fallenb0x/podajnik-lekow/modele stl/kąt lewo.stl

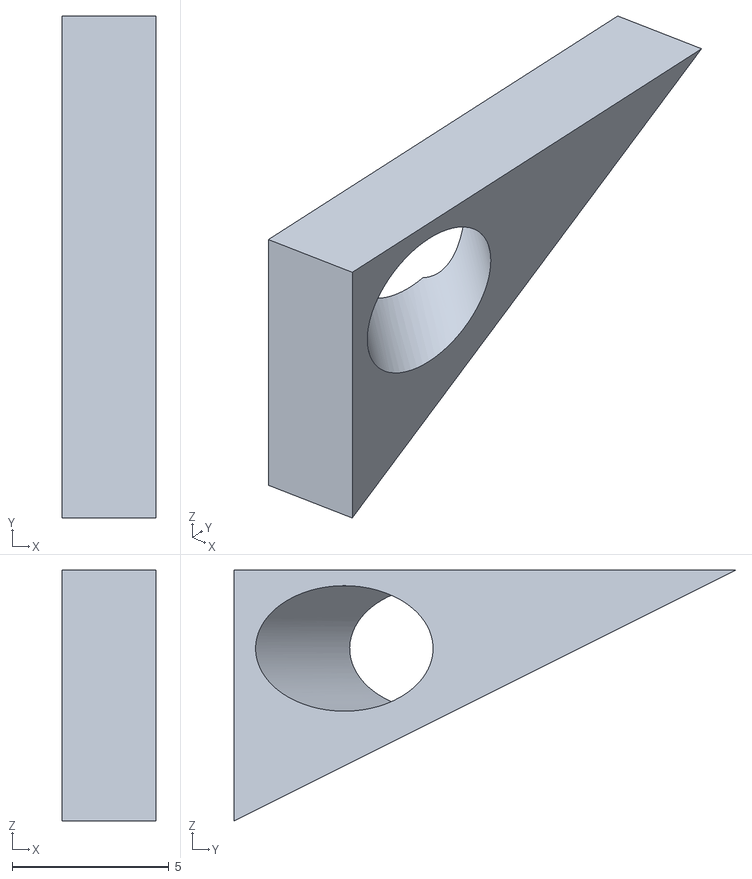
[picture p1: CAD file, 2026-11-06]
modele stl/kąt lewo.stl
3.00 x 16.0 x 8.00
