fallenb0x/podajnik-lekow/modele stl/dach tył.stl

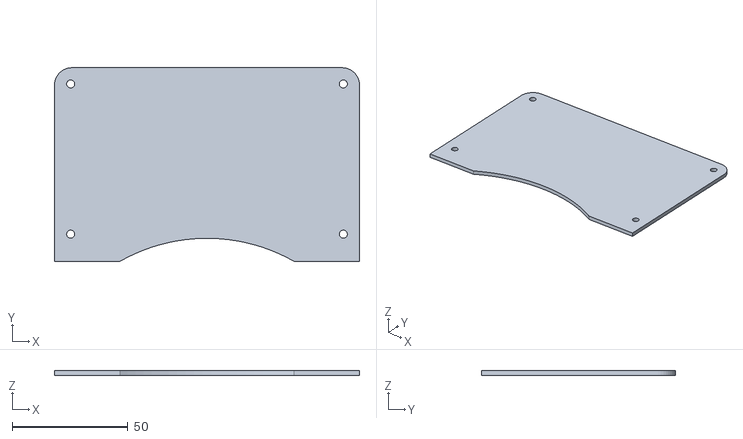
[picture p2: CAD file, 2026-11-06]
modele stl/dach tył.stl
132.0 x 83.8 x 2.00
