fallenb0x/podajnik-lekow/modele stl/dystans na silnik.stl

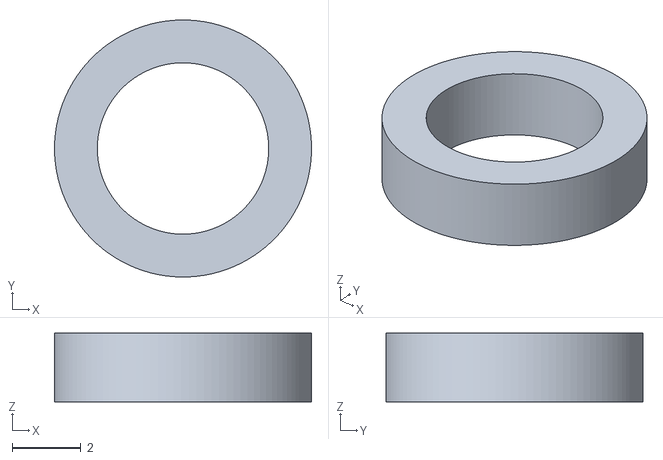
[picture p3: CAD file, 2026-11-06]
modele stl/dystans na silnik.stl
7.50 x 7.50 x 2.00
