fallenb0x/podajnik-lekow/modele stl/baza na sensor.stl

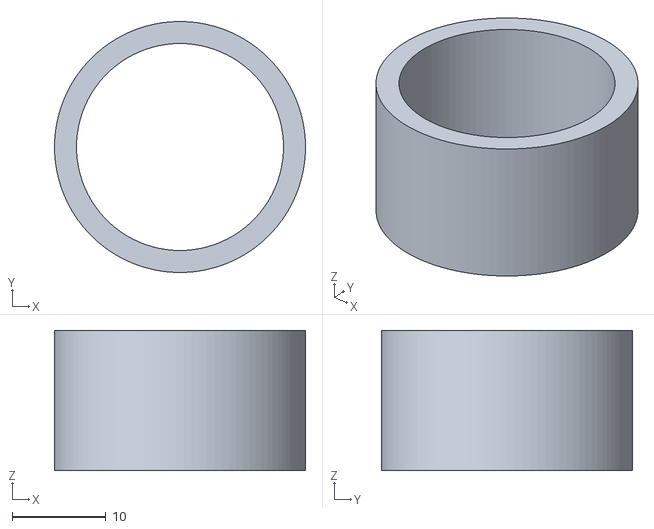
[picture p4: CAD file, 2026-11-06]
modele stl/baza na sensor.stl
26.8 x 26.8 x 15.0
