fallenb0x/podajnik-lekow/modele stl/maska.stl

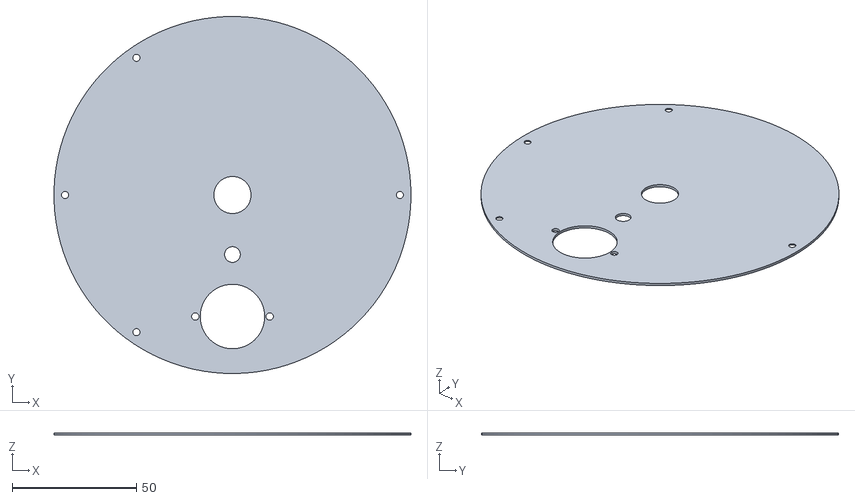
[picture p5: CAD file, 2026-11-06]
modele stl/maska.stl
143.9 x 144.0 x 1.00
