fallenb0x/podajnik-lekow/modele stl/baza.stl

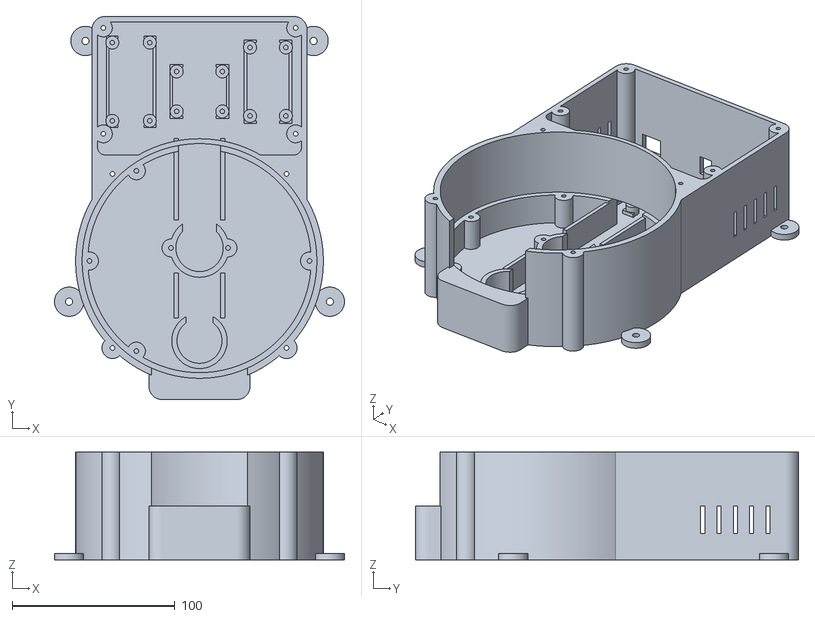
[picture p6: CAD file, 2026-11-03]
modele stl/baza.stl
178.0 x 235.0 x 66.0
