fallenb0x/podajnik-lekow/modele stl/dach przód.stl

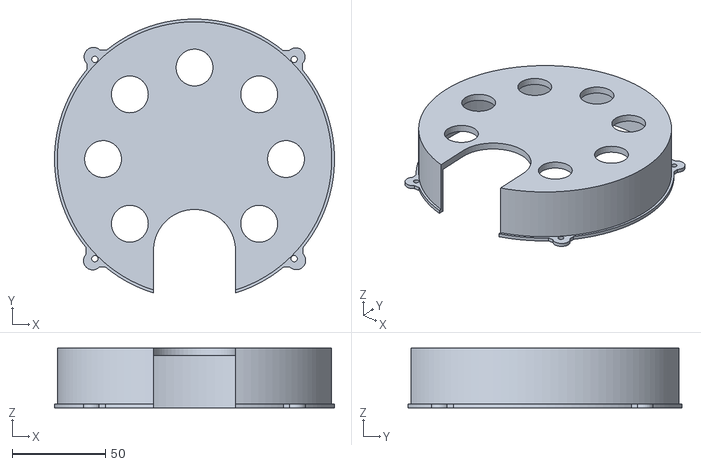
[picture p7: CAD file, 2026-11-03]
modele stl/dach przód.stl
150.0 x 146.7 x 32.0
