fallenb0x/podajnik-lekow/modele stl/Bęben rewolwerowy.stl

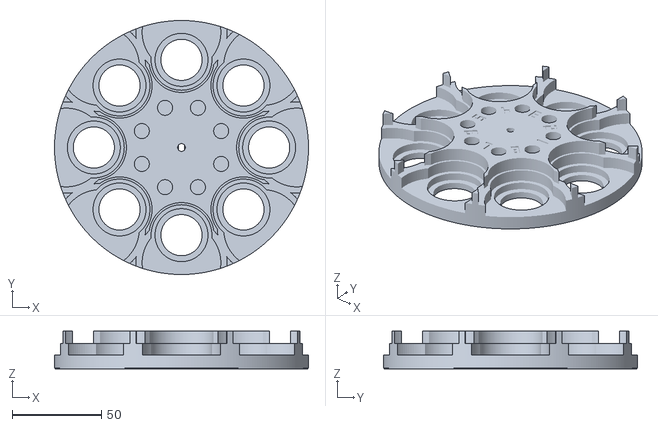
[picture p8: CAD file, 2026-11-03]
modele stl/Bęben rewolwerowy.stl
142.0 x 142.0 x 21.0
