fallenb0x/podajnik-lekow/(list of files, cad)

Other CAD files:
modele stl/kąt prawo.stl
