fallenb0x/podajnik-lekow/program/program.ino

#include <Arduino.h>
#include <EEPROM.h>
#include <WiFi.h>
#include <WebServer.h>
#include <RtcDS1302.h>
#include <ThreeWire.h>

/* =========================================================================
   DEFINICJA PINÓW ZGODNIE Z OPISEM
   ========================================================================= */
#define PIN_LED_GREEN    1   // Zielona dioda (obecność kubeczka)
#define PIN_LED_RED      2   // Czerwona dioda (brak kubeczka / błąd / stan czuwania)
#define PIN_RTC_CLK      5   // DS1302 SCLK / CLK
#define PIN_RTC_DAT      6   // DS1302 IO / DAT
#define PIN_RTC_RST      7   // DS1302 CE / RST
#define PIN_BUZZER       8   // Głośniczek / buzzer (GPIO8 / P8)
#define PIN_STEP_IN1     10  // ULN2003 Driver IN1
#define PIN_STEP_IN2     11  // ULN2003 Driver IN2
#define PIN_STEP_IN3     12  // ULN2003 Driver IN3
#define PIN_STEP_IN4     13  // ULN2003 Driver IN4
#define PIN_US_TRIG      15  // AJ-SR04M TRIG (P15)
#define PIN_US_ECHO      16  // AJ-SR04M ECHO (P16)
#define PIN_BUTTON       19  // Przycisk ręcznego dozowania (do GND z PULLUP)

/* =========================================================================
   DANE PUNKTU DOSTĘPOWEGO (AP) I SERWERA WWW
   ========================================================================= */
const char* AP_SSID = "Podajnik Leków";
const char* AP_PASS = "leki1234";

WebServer server(80);

/* =========================================================================
   STRUKTURA USTAWIEŃ W PAMIĘCI EEPROM (CZUJNIK AJ-SR04M)
   ========================================================================= */
#define EEPROM_MAGIC 0x4D454437 // Wersja 7 konfiguracji (AJ-SR04M)

struct Config {
  uint32_t magic;
  int cupMinDistCm;        // Minimalna odległość kubeczka w cm (np. 3 cm)
  int cupMaxDistCm;        // Maksymalna odległość kubeczka w cm (np. 15 cm)
  int slotSteps[8];        // Ilość kroków silnika dla każdego z 8 slotów
  int currentSlot;         // Wybrany aktywny slot (0 - 7)
  int stepDelayMicros;     // Prędkość silnika w us
  bool buzzerMuted;        // Wyciszenie głośniczka
  int scheduleHours[8];    // Harmonogram: godziny (0 - 23) lub -1
  int scheduleMinutes[8];  // Harmonogram: minuty (0 - 59)
  int scheduleSlot[8];     // Który slot (0 - 7) ma zostać podany o danej godzinie
  int scheduleCount;       // Liczba wpisów w harmonogramie
};

Config config;

/* Inicjalizacja zegara czasu rzeczywistego DS1302 */
ThreeWire myWire(PIN_RTC_DAT, PIN_RTC_CLK, PIN_RTC_RST);
RtcDS1302<ThreeWire> Rtc(myWire);

/* Półkrokowa sekwencja sterowania 28BYJ-48 (8 kroków) */
const uint8_t stepSequence[8][4] = {
  {1, 0, 0, 0},
  {1, 1, 0, 0},
  {0, 1, 0, 0},
  {0, 1, 1, 0},
  {0, 0, 1, 0},
  {0, 0, 1, 1},
  {0, 0, 0, 1},
  {1, 0, 0, 1}
};

int currentStepIndex = 0;
int lastDispenseMinute = -1;
unsigned long lastSensorCheck = 0;
bool lastCupPresent = false;
float cachedDistanceCm = 0.0;
String lastStatusMessage = "Urządzenie gotowe do pracy.";

// Zmienne przypomnienia po 5 minutach
bool waitingForCupPickup = false;
unsigned long dispenseTimestamp = 0;
unsigned long lastReminderAlarm = 0;
const unsigned long CUP_TIMEOUT_MS = 300000; // 5 minut

/* =========================================================================
   FUNKCJE SILNIKA KROKOWEGO
   ========================================================================= */
void motorPowerOff() {
  digitalWrite(PIN_STEP_IN1, LOW);
  digitalWrite(PIN_STEP_IN2, LOW);
  digitalWrite(PIN_STEP_IN3, LOW);
  digitalWrite(PIN_STEP_IN4, LOW);
}

void stepMotorSingle(int dir) {
  if (dir > 0) {
    currentStepIndex = (currentStepIndex + 1) % 8;
  } else {
    currentStepIndex = (currentStepIndex + 7) % 8;
  }
  digitalWrite(PIN_STEP_IN1, stepSequence[currentStepIndex][0]);
  digitalWrite(PIN_STEP_IN2, stepSequence[currentStepIndex][1]);
  digitalWrite(PIN_STEP_IN3, stepSequence[currentStepIndex][2]);
  digitalWrite(PIN_STEP_IN4, stepSequence[currentStepIndex][3]);
}

void rotateMotor(int steps, int dir = 1) {
  for (int i = 0; i < steps; i++) {
    stepMotorSingle(dir);
    delayMicroseconds(config.stepDelayMicros > 800 ? config.stepDelayMicros : 1200);
    yield();
  }
  motorPowerOff();
}

/* =========================================================================
   FUNKCJE SYGNALIZACJI DŹWIĘKOWEJ
   ========================================================================= */
void beep(int frequency = 2000, int durationMs = 100) {
  if (config.buzzerMuted) return;
  tone(PIN_BUZZER, frequency, durationMs);
}

void playDispenseMelody() {
  if (config.buzzerMuted) return;
  const int notes[] = { 1047, 1319, 1568, 2093 };
  const int durations[] = { 100, 100, 100, 250 };
  for (int i = 0; i < 4; i++) {
    tone(PIN_BUZZER, notes[i], durations[i]);
    delay(durations[i] + 30);
  }
}

/* =========================================================================
   POMIAR ODLEGŁOŚCI - CZUJNIK ULTRADŹWIĘKOWY AJ-SR04M (OPTYMALIZACJA 3.3V)
   ========================================================================= */
float measureDistanceCm() {
  // 1. Zapewnienie czystego stanu niskiego przed strzałem
  digitalWrite(PIN_US_TRIG, LOW);
  delayMicroseconds(10);

  // 2. Wysłanie dłuższego impulsu wyzwalającego (30 us) - kluczowe dla zasilania 3.3V!
  digitalWrite(PIN_US_TRIG, HIGH);
  delayMicroseconds(30);
  digitalWrite(PIN_US_TRIG, LOW);

  // 3. Oczekiwanie na odpowiedź ECHO (timeout 60 000 us = 60 ms)
  unsigned long duration = pulseIn(PIN_US_ECHO, HIGH, 60000);
  if (duration == 0) {
    return -1.0; // Brak echa / brak odbicia
  }

  // 4. Przeliczenie na cm: dźwięk pokonuje drogę tam i z powrotem (343 m/s)
  float dist = (float)duration * 0.01715f;
  return dist;
}

// Uśrednianie kilku próbek z odrzuceniem błędów
float getStableDistanceCm() {
  float sum = 0;
  int validCount = 0;
  
  for (int i = 0; i < 4; i++) {
    float d = measureDistanceCm();
    if (d >= 1.0 && d <= 10000.0) {
      sum += d;
      validCount++;
    }
    delay(35); // Dłuższy odstęp między impulsami dla naładowania przetwornika przy 3.3V
  }

  if (validCount > 0) {
    cachedDistanceCm = sum / validCount;
  } else {
    // Sprawdzenie pojedynczego odczytu
    float single = measureDistanceCm();
    cachedDistanceCm = (single >= 1.0 && single <= 10000.0) ? single : -1.0;
  }
  return cachedDistanceCm;
}

bool checkCupPresent() {
  if (cachedDistanceCm <= 0) return false;
  // Kubek znajduje się w zdefiniowanym przedziale odległości (np. 3 - 15 cm)
  return (cachedDistanceCm >= config.cupMinDistCm && cachedDistanceCm <= config.cupMaxDistCm);
}

void updateSensorAndIndicators() {
  getStableDistanceCm();
  bool cup = checkCupPresent();
  lastCupPresent = cup;

  if (cup) {
    digitalWrite(PIN_LED_GREEN, HIGH);
    digitalWrite(PIN_LED_RED, LOW);
  } else {
    digitalWrite(PIN_LED_GREEN, LOW);
    digitalWrite(PIN_LED_RED, HIGH);

    if (waitingForCupPickup) {
      waitingForCupPickup = false;
      noTone(PIN_BUZZER);
      lastStatusMessage = "Kubeczek z lekiem został odebrany. Alarm wyłączony.";
      Serial.println("[ALARM] Kubek odebrany! Zatrzymano alarm.");
    }
  }

  Serial.printf("[AJ-SR04M] Odleglosc: %.1f cm (Zakres: %d-%d cm) => Kubek: %s\n", 
                cachedDistanceCm, config.cupMinDistCm, config.cupMaxDistCm, 
                cup ? "OBECNY (ZIELONY)" : "BRAK (CZERWONY)");
}

/* =========================================================================
   LOGIKA PODAWANIA LEKÓW
   ========================================================================= */
bool dispenseMedication(int slotIdx, const char* reason) {
  if (slotIdx < 0 || slotIdx >= 8) slotIdx = config.currentSlot;
  int stepsToRun = config.slotSteps[slotIdx];

  Serial.printf("\n[DOZOWNIK] Podawanie slotu #%d (%d krokow). Powod: %s\n", slotIdx + 1, stepsToRun, reason);

  rotateMotor(stepsToRun, 1);
  playDispenseMelody();

  config.currentSlot = (slotIdx + 1) % 8;
  EEPROM.put(0, config);
  EEPROM.commit();

  waitingForCupPickup = true;
  dispenseTimestamp = millis();

  lastStatusMessage = String("Podano slot #") + (slotIdx + 1) + " (" + stepsToRun + " kroków). Następny slot: #" + (config.currentSlot + 1);
  Serial.printf("[DOZOWNIK] Podano pomyslnie. Następny slot: #%d\n\n", config.currentSlot + 1);
  return true;
}

/* =========================================================================
   ZARZĄDZANIE PAMIĘCIĄ EEPROM
   ========================================================================= */
void loadConfig() {
  EEPROM.begin(sizeof(Config));
  EEPROM.get(0, config);
  if (config.magic != EEPROM_MAGIC) {
    Serial.println("[EEPROM] Inicjalizacja domyslnych wartosci v7 (AJ-SR04M)...");
    config.magic = EEPROM_MAGIC;
    config.cupMinDistCm = 2;   // Minimalna odległość (np. 2 cm)
    config.cupMaxDistCm = 15;  // Maksymalna odległość kubeczka (np. 15 cm)
    config.currentSlot = 0;
    config.stepDelayMicros = 1200;
    config.buzzerMuted = false;

    for (int i = 0; i < 8; i++) {
      config.slotSteps[i] = 512;
    }

    config.scheduleCount = 1;
    config.scheduleHours[0] = 8;
    config.scheduleMinutes[0] = 0;
    config.scheduleSlot[0] = 0;
    for (int i = 1; i < 8; i++) {
      config.scheduleHours[i] = -1;
      config.scheduleMinutes[i] = 0;
      config.scheduleSlot[i] = i;
    }
    EEPROM.put(0, config);
    EEPROM.commit();
  }
}

void saveConfig() {
  EEPROM.put(0, config);
  EEPROM.commit();
}

/* =========================================================================
   INTERFEJS WEBUI - DARK THEME (HTML/CSS/JS)
   ========================================================================= */
const char PAGE_MAIN[] PROGMEM = R"rawliteral(
<!DOCTYPE html>
<html lang="pl">
<head>
  <meta charset="UTF-8">
  <meta name="viewport" content="width=device-width, initial-scale=1.0">
  <title>Podajnik Leków - Panel</title>
  <style>
    :root {
      --bg: #121418;
      --card: #1c1f26;
      --card-border: #2a303c;
      --text: #e2e8f0;
      --text-muted: #94a3b8;
      --primary: #3b82f6;
      --primary-hover: #2563eb;
      --green: #10b981;
      --red: #ef4444;
      --slot-bg: #262c38;
      --slot-active: #1e3a8a;
    }
    * { box-sizing: border-box; }
    body {
      font-family: -apple-system, BlinkMacSystemFont, 'Segoe UI', Roboto, Helvetica, Arial, sans-serif;
      background: var(--bg);
      color: var(--text);
      margin: 0;
      padding: 16px;
    }
    .container { max-width: 650px; margin: 0 auto; }
    h1 {
      text-align: center;
      color: #60a5fa;
      margin: 10px 0 4px 0;
      font-size: 26px;
      letter-spacing: 0.5px;
    }
    p.subtitle {
      text-align: center;
      color: var(--text-muted);
      margin-top: 0;
      margin-bottom: 22px;
      font-size: 14px;
    }
    .card {
      background: var(--card);
      border: 1px solid var(--card-border);
      border-radius: 14px;
      padding: 18px;
      margin-bottom: 18px;
      box-shadow: 0 8px 24px rgba(0,0,0,0.35);
    }
    h2 {
      font-size: 17px;
      margin: 0 0 14px 0;
      border-bottom: 1px solid var(--card-border);
      padding-bottom: 10px;
      color: #93c5fd;
      display: flex;
      align-items: center;
      gap: 8px;
    }
    .status-badge {
      display: inline-block;
      padding: 6px 16px;
      border-radius: 20px;
      font-weight: 700;
      font-size: 13px;
      letter-spacing: 0.5px;
      color: white;
    }
    .badge-cup-yes { background-color: var(--green); box-shadow: 0 0 12px rgba(16,185,129,0.4); }
    .badge-cup-no { background-color: var(--red); box-shadow: 0 0 12px rgba(239,68,68,0.4); }
    .btn {
      display: block;
      width: 100%;
      background: var(--primary);
      color: white;
      border: none;
      padding: 12px;
      border-radius: 8px;
      font-size: 15px;
      font-weight: 600;
      cursor: pointer;
      text-align: center;
      transition: background 0.2s, transform 0.1s;
    }
    .btn:hover { background: var(--primary-hover); }
    .btn:active { transform: scale(0.99); }
    .btn-secondary { background: #374151; }
    .btn-secondary:hover { background: #4b5563; }
    .row {
      display: flex;
      justify-content: space-between;
      align-items: center;
      margin-bottom: 12px;
      font-size: 14px;
    }
    label { font-weight: 500; color: var(--text-muted); }
    input[type="number"], input[type="text"], input[type="time"] {
      background: #111827;
      border: 1px solid #374151;
      color: #f3f4f6;
      padding: 8px 10px;
      border-radius: 8px;
      font-size: 14px;
      text-align: center;
      outline: none;
    }
    .dist-highlight {
      font-size: 20px;
      font-weight: bold;
      color: #38bdf8;
    }
    .slots-grid {
      display: grid;
      grid-template-columns: repeat(2, 1fr);
      gap: 10px;
      margin-bottom: 14px;
    }
    .slot-card {
      background: var(--slot-bg);
      border: 1px solid #334155;
      padding: 10px 12px;
      border-radius: 8px;
      display: flex;
      justify-content: space-between;
      align-items: center;
    }
    .slot-card.active-slot {
      border-color: #60a5fa;
      background: var(--slot-active);
    }
    .slot-label { font-size: 13px; font-weight: 600; color: #93c5fd; }
    .slot-steps-in { width: 85px !important; }
    .log-box {
      background: #111827;
      border: 1px solid #1f2937;
      padding: 10px;
      border-radius: 8px;
      font-family: monospace;
      font-size: 13px;
      color: #94a3b8;
    }
  </style>
</head>
<body>
  <div class="container">
    <h1>💊 Podajnik Leków</h1>
    <p class="subtitle">Panel WebUI Dark Mode • IP: 192.168.4.1</p>

    <!-- KARTA 1: STATUS -->
    <div class="card">
      <h2>📊 Bieżący stan</h2>
      <div class="row">
        <span>Status kubeczka:</span>
        <span id="cupBadge" class="status-badge badge-cup-no">Łączenie...</span>
      </div>

      <div class="row" style="margin-bottom: 6px;">
        <span>Odległość (AJ-SR04M):</span>
        <span id="valDist" class="dist-highlight">-- cm</span>
      </div>
      <div class="row">
        <span>Zdefiniowany zakres kubka:</span>
        <strong id="valRange" style="color: #94a3b8;">-- cm</strong>
      </div>
      <div class="row">
        <span>Zegar DS1302:</span>
        <strong id="valTime" style="color: #60a5fa;">--:--:--</strong>
      </div>
      <div class="row">
        <span>Kolejny slot do podania:</span>
        <strong id="valNextSlot" style="color: #34d399;">Slot #1</strong>
      </div>
      <div class="row">
        <span>Głośniczek dźwiękowy:</span>
        <button id="btnMuteToggle" class="status-badge" style="border:none; cursor:pointer;" onclick="toggleMute()">Ładowanie...</button>
      </div>
      <div class="row" style="margin-bottom: 4px;">
        <span>Komunikat:</span>
      </div>
      <div id="valStatus" class="log-box">Wczytywanie danych...</div>

      <button class="btn" style="margin-top: 14px;" onclick="dispenseCurrent()">PODAJ AKTUALNY SLOT</button>
      <button class="btn btn-secondary" style="margin-top: 8px;" onclick="manualNextSlot()">OBRÓĆ DO NASTĘPNEGO SLOTU</button>
    </div>

    <!-- KARTA 2: KALIBRACJA CZUJNIKA AJ-SR04M -->
    <div class="card">
      <h2>📏 Kalibracja czujnika odległości (AJ-SR04M)</h2>
      <p style="font-size: 13px; color: var(--text-muted); margin-top: 0;">Określ przedział odległości, w którym sensor widzi obecność kubka:</p>
      <form action="/save_sensor" method="POST">
        <div class="row">
          <label>Minimalna odległość (cm):</label>
          <input type="number" name="min_dist" id="inMinDist" min="0" max="10000" required>
        </div>
        <div class="row">
          <label>Maksymalna odległość (cm):</label>
          <input type="number" name="max_dist" id="inMaxDist" min="1" max="10000" required>
        </div>
        <button type="submit" class="btn btn-secondary" style="margin-top: 8px;">Zapisz zakres odległości</button>
      </form>
    </div>

    <!-- KARTA 3: KALIBRACJA 8 SLOTÓW (PRZEDZIAŁEK) -->
    <div class="card">
      <h2>⚙️ Kalibracja kroków silnika dla 8 slotów</h2>
      <p style="font-size: 13px; color: var(--text-muted); margin-top: 0;">Ustaw indywidualną liczbę kroków silnika dla każdej przedziałki:</p>
      <form action="/save_slots" method="POST">
        <div class="slots-grid">
          <div class="slot-card" id="sc0"><span class="slot-label">Slot #1</span><input type="number" name="s0" id="s0" class="slot-steps-in" min="1" max="16384"></div>
          <div class="slot-card" id="sc1"><span class="slot-label">Slot #2</span><input type="number" name="s1" id="s1" class="slot-steps-in" min="1" max="16384"></div>
          <div class="slot-card" id="sc2"><span class="slot-label">Slot #3</span><input type="number" name="s2" id="s2" class="slot-steps-in" min="1" max="16384"></div>
          <div class="slot-card" id="sc3"><span class="slot-label">Slot #4</span><input type="number" name="s3" id="s3" class="slot-steps-in" min="1" max="16384"></div>
          <div class="slot-card" id="sc4"><span class="slot-label">Slot #5</span><input type="number" name="s4" id="s4" class="slot-steps-in" min="1" max="16384"></div>
          <div class="slot-card" id="sc5"><span class="slot-label">Slot #6</span><input type="number" name="s5" id="s5" class="slot-steps-in" min="1" max="16384"></div>
          <div class="slot-card" id="sc6"><span class="slot-label">Slot #7</span><input type="number" name="s6" id="s6" class="slot-steps-in" min="1" max="16384"></div>
          <div class="slot-card" id="sc7"><span class="slot-label">Slot #8</span><input type="number" name="s7" id="s7" class="slot-steps-in" min="1" max="16384"></div>
        </div>
        <div class="row">
          <label>Wyciszenie głośniczka:</label>
          <input type="checkbox" name="muted" id="inMuted" style="transform: scale(1.3); accent-color: var(--primary);">
        </div>
        <button type="submit" class="btn btn-secondary">Zapisz ustawienia slotów</button>
      </form>

      <div style="display: flex; gap: 8px; margin-top: 10px;">
        <button type="button" class="btn btn-secondary" style="font-size: 13px;" onclick="testRotate(64)">+64</button>
        <button type="button" class="btn btn-secondary" style="font-size: 13px;" onclick="testRotate(-64)">-64</button>
        <button type="button" class="btn btn-secondary" style="font-size: 13px;" onclick="testRotate(256)">+256</button>
        <button type="button" class="btn btn-secondary" style="font-size: 13px;" onclick="testRotate(-256)">-256</button>
      </div>

      <div style="margin-top: 15px; padding-top: 12px; border-top: 1px solid var(--card-border);">
        <label style="color: #93c5fd; font-weight: 600;">📍 Punkt zerowy podajnika:</label>
        <p style="font-size: 12px; color: var(--text-muted); margin: 4px 0 10px 0;">Użyj przycisków powyżej aby ustawić komorę na pozycji wyjściowej, a następnie zapisz to jako Punkt Zero (Slot #1):</p>
        <div style="display: flex; gap: 10px;">
          <button type="button" class="btn" style="background: #059669;" onclick="setZeroPoint()">USTAW AKTUALNĄ POZYCJĘ JAKO PUNKT ZERO (SLOT #1)</button>
        </div>
      </div>
    </div>

    <!-- KARTA 4: HARMONOGRAM -->
    <div class="card">
      <h2>⏰ Codzienny harmonogram podawania</h2>
      <p style="font-size: 13px; color: var(--text-muted); margin-top: 0;">Podajnik obróci się automatycznie każdego dnia dokładnie o wybranej godzinie:</p>
      <form action="/save_schedule" method="POST">
        <div class="row" style="justify-content: flex-start; gap: 15px;">
          <label style="font-size: 15px; color: #fff;">Godzina podania:</label>
          <input type="time" name="daily_time" id="dailyTime" style="font-size: 16px; padding: 10px; width: 140px;" required>
        </div>
        <button type="submit" class="btn btn-secondary" style="margin-top: 10px;">Zapisz codzienną godzinę</button>
      </form>
    </div>

    <!-- KARTA 5: ZEGAR -->
    <div class="card">
      <h2>🕒 Synchronizacja czasu</h2>
      <button class="btn btn-secondary" onclick="syncBrowserTime()">Pobierz czas z telefonu / komputera</button>
    </div>
  </div>

  <script>
    let firstLoad = true;

    function refreshData() {
      fetch('/api/data')
        .then(r => r.json())
        .then(d => {
          document.getElementById('cupBadge').className = 'status-badge ' + (d.cup ? 'badge-cup-yes' : 'badge-cup-no');
          document.getElementById('cupBadge').innerText = d.cup ? 'KUBEK NA MIEJSCU' : 'BRAK KUBECZKA';
          
          document.getElementById('valDist').innerText = (d.dist >= 0) ? d.dist + ' cm' : 'Brak echa / poza zakresem';
          document.getElementById('valRange').innerText = d.minDist + ' - ' + d.maxDist + ' cm';

          document.getElementById('valTime').innerText = d.time;
          document.getElementById('valNextSlot').innerText = 'Slot #' + (d.curSlot + 1);
          document.getElementById('valStatus').innerText = d.statusMsg;

          // Automatyczne dopasowanie czasu przy otwarciu strony
          checkAutoSyncRtc(d.time);

          // Przycisk szybkiego wyciszenia
          let muteBtn = document.getElementById('btnMuteToggle');
          if (d.muted) {
            muteBtn.innerText = '🔇 WYCISZONY (Kliknij, aby włączyć)';
            muteBtn.style.backgroundColor = '#ef4444';
          } else {
            muteBtn.innerText = '🔊 DŹWIĘK WŁĄCZONY (Kliknij, aby wyciszyć)';
            muteBtn.style.backgroundColor = '#10b981';
          }

          // Podświetlenie aktywnego slotu
          for (let i = 0; i < 8; i++) {
            let el = document.getElementById('sc' + i);
            if (el) {
              if (i === d.curSlot) el.classList.add('active-slot');
              else el.classList.remove('active-slot');
            }
          }

          if (firstLoad) {
            document.getElementById('inMinDist').value = d.minDist;
            document.getElementById('inMaxDist').value = d.maxDist;
            document.getElementById('inMuted').checked = d.muted;

            for (let i = 0; i < 8; i++) {
              document.getElementById('s' + i).value = d.slotSteps[i];
            }
            if (d.dailyTime) {
              document.getElementById('dailyTime').value = d.dailyTime;
            }
            firstLoad = false;
          }
        });
    }

    function dispenseCurrent() {
      fetch('/api/dispense', { method: 'POST' })
        .then(r => r.text())
        .then(msg => {
          alert(msg);
          refreshData();
        });
    }

    function manualNextSlot() {
      fetch('/api/force_advance', { method: 'POST' })
        .then(r => r.text())
        .then(msg => {
          alert(msg);
          refreshData();
        });
    }

    function toggleMute() {
      fetch('/api/toggle_mute', { method: 'POST' })
        .then(() => refreshData());
    }

    function testRotate(st) {
      fetch('/api/rotate?steps=' + st, { method: 'POST' })
        .then(() => refreshData());
    }

    function setZeroPoint() {
      if (confirm('Czy chcesz ustawić bieżącą pozycję silnika jako Punkt Zero (Slot #1)?')) {
        fetch('/api/set_zero', { method: 'POST' })
          .then(r => r.text())
          .then(msg => {
            alert(msg);
            refreshData();
          });
      }
    }

    function syncBrowserTime() {
      const now = new Date();
      fetch('/api/set_time?h=' + now.getHours() + '&m=' + now.getMinutes() + '&s=' + now.getSeconds(), { method: 'POST' })
        .then(r => r.text())
        .then(msg => {
          alert(msg);
          refreshData();
        });
    }

    // Automatyczna synchronizacja czasu zegara RTC przy pierwszym otwarciu WebUI
    let rtcAutoSynced = false;
    function checkAutoSyncRtc(rtcTimeString) {
      if (!rtcAutoSynced && rtcTimeString) {
        rtcAutoSynced = true;
        const now = new Date();
        const parts = rtcTimeString.split(':');
        if (parts.length === 3) {
          const rtcH = parseInt(parts[0]);
          const rtcM = parseInt(parts[1]);
          // Jeśli czas różni się o więcej niż 2 minuty, synchronizuj automatycznie w tle
          if (Math.abs(rtcH - now.getHours()) > 0 || Math.abs(rtcM - now.getMinutes()) > 2) {
            console.log('Automatyczna synchronizacja zegara DS1302 z czasem telefonu...');
            fetch('/api/set_time?h=' + now.getHours() + '&m=' + now.getMinutes() + '&s=' + now.getSeconds(), { method: 'POST' });
          }
        }
      }
    }

    setInterval(refreshData, 1500);
    window.onload = refreshData;
  </script>
</body>
</html>
)rawliteral";

/* =========================================================================
   ENDPOINTY SERWERA WWW
   ========================================================================= */
void handleRoot() {
  server.send_P(200, "text/html; charset=utf-8", PAGE_MAIN);
}

void handleApiData() {
  RtcDateTime now = Rtc.GetDateTime();
  char timeBuf[16];
  snprintf(timeBuf, sizeof(timeBuf), "%02u:%02u:%02u", now.Hour(), now.Minute(), now.Second());

  char dailyBuf[8];
  if (config.scheduleHours[0] >= 0) {
    snprintf(dailyBuf, sizeof(dailyBuf), "%02d:%02d", config.scheduleHours[0], config.scheduleMinutes[0]);
  } else {
    snprintf(dailyBuf, sizeof(dailyBuf), "08:00");
  }

  bool cup = checkCupPresent();

  String json = "{";
  json += "\"cup\":" + String(cup ? "true" : "false") + ",";
  json += "\"dist\":" + String(cachedDistanceCm, 1) + ",";
  json += "\"minDist\":" + String(config.cupMinDistCm) + ",";
  json += "\"maxDist\":" + String(config.cupMaxDistCm) + ",";
  json += "\"curSlot\":" + String(config.currentSlot) + ",";
  json += "\"muted\":" + String(config.buzzerMuted ? "true" : "false") + ",";
  json += "\"time\":\"" + String(timeBuf) + "\",";
  json += "\"dailyTime\":\"" + String(dailyBuf) + "\",";
  json += "\"statusMsg\":\"" + lastStatusMessage + "\",";
  
  json += "\"slotSteps\":[";
  for (int i = 0; i < 8; i++) {
    json += String(config.slotSteps[i]);
    if (i < 7) json += ",";
  }
  json += "]";
  json += "}";

  server.send(200, "application/json", json);
}

void handleApiDispense() {
  dispenseMedication(config.currentSlot, "Żądanie z WebUI");
  server.send(200, "text/plain; charset=utf-8", "Lek został podany!");
}

void handleApiForceAdvance() {
  int slotIdx = config.currentSlot;
  int stepsToRun = config.slotSteps[slotIdx];
  rotateMotor(stepsToRun, 1);
  playDispenseMelody();
  config.currentSlot = (slotIdx + 1) % 8;
  saveConfig();
  lastStatusMessage = String("Obrócono bęben do Slot #") + (config.currentSlot + 1);
  server.send(200, "text/plain; charset=utf-8", "Wykonano pełny obrót do następnego slotu!");
}

void handleApiToggleMute() {
  config.buzzerMuted = !config.buzzerMuted;
  saveConfig();
  lastStatusMessage = config.buzzerMuted ? "Głośniczek został wyciszony." : "Dźwięk głośniczka włączony.";
  server.send(200, "text/plain", "OK");
}

void handleApiRotate() {
  if (server.hasArg("steps")) {
    int st = server.arg("steps").toInt();
    rotateMotor(abs(st), st >= 0 ? 1 : -1);
    lastStatusMessage = String("Wykonano obrót testowy o ") + st + " kroków.";
    server.send(200, "text/plain", "OK");
  } else {
    server.send(400, "text/plain", "Brak parametru");
  }
}

void handleApiSetZero() {
  config.currentSlot = 0;
  saveConfig();
  lastStatusMessage = "Zresetowano pozycję! Ustawiono Punkt Zero na Slot #1.";
  server.send(200, "text/plain; charset=utf-8", "Ustawiono aktualną pozycję jako Punkt Zero (Slot #1)!");
}

void handleApiSetTime() {
  if (server.hasArg("h") && server.hasArg("m") && server.hasArg("s")) {
    int h = server.arg("h").toInt();
    int m = server.arg("m").toInt();
    int s = server.arg("s").toInt();
    RtcDateTime cur = Rtc.GetDateTime();
    RtcDateTime dt(cur.Year() < 2020 ? 2026 : cur.Year(), 
                   cur.Month() == 0 ? 1 : cur.Month(), 
                   cur.Day() == 0 ? 1 : cur.Day(), 
                   h, m, s);
    Rtc.SetDateTime(dt);
    lastStatusMessage = String("Czas zsynchronizowany: ") + h + ":" + m + ":" + s;
    server.send(200, "text/plain; charset=utf-8", "Czas został zsynchronizowany!");
  } else {
    server.send(400, "text/plain", "Błędne dane");
  }
}

void handleSaveSensor() {
  if (server.hasArg("min_dist") && server.hasArg("max_dist")) {
    config.cupMinDistCm = server.arg("min_dist").toInt();
    config.cupMaxDistCm = server.arg("max_dist").toInt();
    saveConfig();
    updateSensorAndIndicators();
    lastStatusMessage = "Zapisano zakres odległości: " + String(config.cupMinDistCm) + " - " + String(config.cupMaxDistCm) + " cm.";
  }
  server.sendHeader("Location", "/");
  server.send(303);
}

void handleSaveSlots() {
  for (int i = 0; i < 8; i++) {
    String argName = "s" + String(i);
    if (server.hasArg(argName)) {
      config.slotSteps[i] = server.arg(argName).toInt();
    }
  }
  config.buzzerMuted = server.hasArg("muted");
  saveConfig();
  lastStatusMessage = "Zapisano kalibrację kroków dla 8 slotów.";
  server.sendHeader("Location", "/");
  server.send(303);
}

void handleSaveSchedule() {
  if (server.hasArg("daily_time")) {
    String val = server.arg("daily_time");
    int colon = val.indexOf(':');
    if (colon > 0) {
      config.scheduleHours[0] = val.substring(0, colon).toInt();
      config.scheduleMinutes[0] = val.substring(colon + 1).toInt();
      config.scheduleCount = 1;
      saveConfig();
      lastStatusMessage = "Zapisano codzienną godzinę podawania: " + val;
    }
  }
  server.sendHeader("Location", "/");
  server.send(303);
}

/* =========================================================================
   HARMONOGRAM PODAWANIA (CODZIENNY)
   ========================================================================= */
void checkSchedule() {
  RtcDateTime now = Rtc.GetDateTime();
  if (!now.IsValid()) return;

  if (now.Minute() != lastDispenseMinute) {
    lastDispenseMinute = -1;
  }

  if (lastDispenseMinute == now.Minute()) return;

  if (config.scheduleHours[0] >= 0) {
    if (config.scheduleHours[0] == now.Hour() && config.scheduleMinutes[0] == now.Minute()) {
      lastDispenseMinute = now.Minute();
      char buffer[32];
      snprintf(buffer, sizeof(buffer), "Codzienny obrót o [%02d:%02d]", now.Hour(), now.Minute());
      Serial.printf("[RTC] Uruchomiono codzienny harmonogram o %02d:%02d\n", now.Hour(), now.Minute());
      dispenseMedication(config.currentSlot, buffer);
    }
  }
}

/* =========================================================================
   PRZYCISK FIZYCZNY
   ========================================================================= */
void handleButton() {
  static unsigned long lastDebounceTime = 0;
  static int lastButtonState = HIGH;
  int reading = digitalRead(PIN_BUTTON);

  if (reading != lastButtonState) {
    lastDebounceTime = millis();
  }

  if ((millis() - lastDebounceTime) > 50) {
    static int buttonState = HIGH;
    if (reading != buttonState) {
      buttonState = reading;
      if (buttonState == LOW) {
        Serial.println("[PRZYCISK] Wciśnięto przycisk fizyczny! Obrót bębna...");
        dispenseMedication(config.currentSlot, "Przycisk fizyczny GPIO19");
      }
    }
  }
  lastButtonState = reading;
}

/* =========================================================================
   ALARM PRZYPOMNIENIA PO 5 MINUTACH
   ========================================================================= */
void checkCupReminderAlarm() {
  if (!waitingForCupPickup) return;

  if (millis() - dispenseTimestamp >= CUP_TIMEOUT_MS) {
    if (checkCupPresent()) {
      if (millis() - lastReminderAlarm >= 2000) {
        lastReminderAlarm = millis();
        lastStatusMessage = "UWAGA: Lek czeka od ponad 5 minut! Odbierz kubeczek.";
        Serial.println("[PRZYPOMNIENIE] Męczący alarm: minęło 5 minut, a kubek nadal stoi!");
        playDispenseMelody();
      }
    } else {
      waitingForCupPickup = false;
      noTone(PIN_BUZZER);
    }
  }
}

/* =========================================================================
   SETUP & LOOP
   ========================================================================= */
void setup() {
  Serial.begin(115200);
  delay(500);

  pinMode(PIN_LED_GREEN, OUTPUT);
  pinMode(PIN_LED_RED, OUTPUT);
  pinMode(PIN_BUTTON, INPUT_PULLUP);
  pinMode(PIN_BUZZER, OUTPUT);

  // Konfiguracja pinów czujnika ultradźwiękowego AJ-SR04M
  pinMode(PIN_US_TRIG, OUTPUT);
  pinMode(PIN_US_ECHO, INPUT);
  digitalWrite(PIN_US_TRIG, LOW);

  pinMode(PIN_STEP_IN1, OUTPUT);
  pinMode(PIN_STEP_IN2, OUTPUT);
  pinMode(PIN_STEP_IN3, OUTPUT);
  pinMode(PIN_STEP_IN4, OUTPUT);
  motorPowerOff();

  loadConfig();

  // Inicjalizacja zegara czasu rzeczywistego DS1302
  Rtc.Begin();
  if (Rtc.GetIsWriteProtected()) {
    Serial.println("[RTC] Wyłączanie ochrony zapisu DS1302...");
    Rtc.SetIsWriteProtected(false);
  }
  if (!Rtc.GetIsRunning()) {
    Serial.println("[RTC] Uruchamianie oscylatora DS1302...");
    Rtc.SetIsRunning(true);
  }

  // Weryfikacja poprawności czasu z DS1302
  RtcDateTime nowRtc = Rtc.GetDateTime();
  if (!Rtc.IsDateTimeValid() || nowRtc.Year() < 2024 || nowRtc.Year() > 2099) {
    Serial.println("[RTC] Wykryto niepoprawny czas w pamięci DS1302! Ustawianie czasu kompilacji programu...");
    RtcDateTime compiled = RtcDateTime(__DATE__, __TIME__);
    Rtc.SetDateTime(compiled);
  } else {
    Serial.printf("[RTC] DS1302 czas prawidłowy: %02u:%02u:%02u\n", nowRtc.Hour(), nowRtc.Minute(), nowRtc.Second());
  }

  WiFi.mode(WIFI_AP);
  IPAddress local_ip(192, 168, 4, 1);
  IPAddress gateway(192, 168, 4, 1);
  IPAddress subnet(255, 255, 255, 0);
  WiFi.softAPConfig(local_ip, gateway, subnet);
  WiFi.softAP(AP_SSID, AP_PASS);

  server.on("/", HTTP_GET, handleRoot);
  server.on("/api/data", HTTP_GET, handleApiData);
  server.on("/api/dispense", HTTP_POST, handleApiDispense);
  server.on("/api/force_advance", HTTP_POST, handleApiForceAdvance);
  server.on("/api/toggle_mute", HTTP_POST, handleApiToggleMute);
  server.on("/api/rotate", HTTP_POST, handleApiRotate);
  server.on("/api/set_zero", HTTP_POST, handleApiSetZero);
  server.on("/api/set_time", HTTP_POST, handleApiSetTime);
  server.on("/save_sensor", HTTP_POST, handleSaveSensor);
  server.on("/save_slots", HTTP_POST, handleSaveSlots);
  server.on("/save_schedule", HTTP_POST, handleSaveSchedule);
  server.begin();

  updateSensorAndIndicators();
}

void loop() {
  server.handleClient();

  // Sprawdzanie odległości ultradźwiękowej co 1 sekundę
  if (millis() - lastSensorCheck >= 1000) {
    lastSensorCheck = millis();
    updateSensorAndIndicators();
  }

  checkCupReminderAlarm();
  handleButton();
  checkSchedule();
  yield();
}
