fallenb0x/podajnik-lekow/(commit log)

2026-11-03 Initial commit: Automatyczny Podajnik Lekow ESP32-S3 z modelami 3D
    [Bęben rewolwerowy.stl, baza.stl, czujnik i ledy.stl, dach przód.stl, dach tył.stl, maska.stl]
2026-11-06 Aktualizacja projektu: przejscie na czujnik AJ-SR04M, pelna dokumentacja techniczna i nowe modele STL
    [baza na sensor.stl, czujnik i ledy.stl, dach tył.stl, dystans na silnik.stl, kąt lewo.stl, kąt prawo.stl, maska.stl]
2026-11-06 Aktualizacja README: dokladna struktura plikow STL, oprogramowania i dokumentacji
